itsmeibii/SplitFlap-Control-Board/housing/enclosure/preview.png

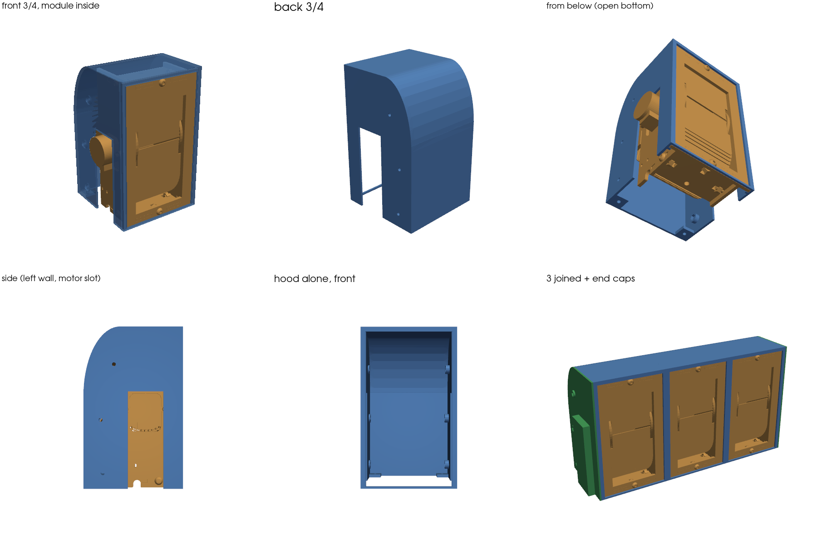
housing/enclosure/preview.png
