itsmeibii/SplitFlap-Control-Board/control board/ControlBoard/fab/DigiKey_BOM.csv

Qty per board | References | Value | Footprint | DigiKey Part # | Who solders
2 | C1 C2 | 10u | C_1206_3216Metric | 4713-GMC31X7R106K50NTCT-ND | You
3 | C3 C6 C11 | 0.1u | C_0805_2012Metric | 1276-1003-1-ND | You
1 | C4 | 47n | C_0805_2012Metric | 399-C0805C473K5RACTUCT-ND | You
1 | C5 | 150p | C_0805_2012Metric | 399-C0805C151J5GACTUCT-ND | You
2 | C7 C8 | 22u | C_1210_3225Metric | 490-3889-1-ND | You
2 | C9 C12 | 2.2n | C_0805_2012Metric | 1276-2993-1-ND | You
2 | C10 C14 | 1u | C_0805_2012Metric | 399-C0805C105K3RACTUCT-ND | You
1 | C13 | 47u | C_1210_3225Metric | 587-5479-1-ND | You
1 | D1 | SMAJ6.0A | D_SMA | SMAJ6.0ALFCT-ND | You
1 | D2 | SMAJ22A | D_SMA | SMAJ22ABCT-ND | You
1 | D3 | LTST-C170KRKT | LED_0805_2012Metric_Pad1.15x1.40mm_HandSolder | 160-1415-1-ND | You
1 | D4 | LTST-C170KGKT | LED_0805_2012Metric_Pad1.15x1.40mm_HandSolder | 160-1414-1-ND | You
1 | D5 | LTST-C170TBKT | LED_0805_2012Metric_Pad1.15x1.40mm_HandSolder | 160-1579-1-ND | You
1 | F1 | 3A | Fuseholder_Blade_Mini_Keystone_3568 | 36-3568-ND | You
1 | F2 | 7.5A | Fuseholder_Blade_Mini_Keystone_3568 | 36-3568-ND | You
1 | J1 | Conn_02x04_Odd_Even | IDC-Header_2x04_P2.54mm_Vertical | 732-5395-ND | You
1 | J2 | Conn_02x08_Odd_Even | IDC-Header_2x08_P2.54mm_Vertical | 732-2095-ND | You
1 | J4 | Conn_01x02_Pin | TerminalBlock_CUI_TB007-508-02_1x02_P5.08mm_Horizontal | 102-6203-ND | You
1 | J5 | Conn_01x03_Pin | TerminalBlock_CUI_TB007-508-03_1x03_P5.08mm_Horizontal | 102-6204-ND | You
1 | J6 | Raspberry_Pi_4 | PinSocket_2x20_P2.54mm_Vertical | 2223-SSK04-FPH-254-B20-ND | You
1 | L1 | 3.3u | L_Wuerth_HCI-1050 | 732-1169-1-ND | You
2 | R1 R11 | 220 | R_0805_2012Metric | 311-220CRCT-ND | You
1 | R2 | 169k | R_0805_2012Metric | RMCF0805FT169KCT-ND | You
1 | R3 | 36.5k | R_0805_2012Metric | 311-36.5KCRCT-ND | You
1 | R4 | 52.3k | R_0805_2012Metric | 311-52.3KCRCT-ND | You
2 | R5 R14 | 10k | R_0805_2012Metric | 311-10.0KCRCT-ND | You
1 | R7 | 73.2k | R_0805_2012Metric | 311-73.2KCRCT-ND | You
1 | R8 | 49.9 | R_0805_2012Metric | 311-49.9CRCT-ND | You
1 | R10 | 49.9k | R_0805_2012Metric | 311-49.9KCRCT-ND | You
1 | R12 | 35.7k | R_0805_2012Metric | 311-35.7KCRCT-ND | You
1 | R13 | 2.87k | R_0805_2012Metric | 311-2.87KCRCT-ND | You
1 | R15 | 953 | R_0805_2012Metric | 311-953CRCT-ND | You
2 | R16 R17 | 47k | R_0805_2012Metric | 311-47.0KCRCT-ND | You
1 | R18 | 16.5k | R_0805_2012Metric | 311-16.5KCRCT-ND | You
1 | R19 | 1k | R_0805_2012Metric | 311-1.00KCRCT-ND | You
2 | SW1 SW2 | SW_Push | SW_PUSH_6mm | SW400-ND | You
1 | U1 | Adafruit_HUSB238_Breakout | Adafruit_HUSB238_Breakout | 1528-5807-ND | You
1 | U2 | TPS56A37RPA | Texas_RPA0010A_VQFN-HR-10_3x3mm_P0.5mm | 296-TPS56A37RPARCT-ND | JLC (Global Sourcing - do not order)
1 | U3 | TPS259474ARPW | Texas_RPW0010A_VQFN-HR-10_2x2mm_P0.475mm | 296-TPS259474ARPWRCT-ND | JLC (Global Sourcing - do not order)
6 | TP1,TP2,TP3,TP4,TP5,TP6 | TestPoint | TestPoint_Pad_D1.0mm | (none - bare copper pad) | Nothing to buy or solder
