itsmeibii/SplitFlap-Control-Board/control board/ControlBoard/fab/jlc_assembly/ControlBoard_BOM_JLC.csv

Comment | Designator | Footprint | LCSC Part # | Manufacturer | Manufacturer Part Number
TPS56A37RPAR | U2 | Texas_RPA0010A_VQFN-HR-10_3x3mm_P0.5mm |  | Texas Instruments | TPS56A37RPAR
TPS259474ARPWR | U3 | Texas_RPW0010A_VQFN-HR-10_2x2mm_P0.475mm |  | Texas Instruments | TPS259474ARPWR
