itsmeibii/SplitFlap-Control-Board/housing/enclosure/row_assembly.step

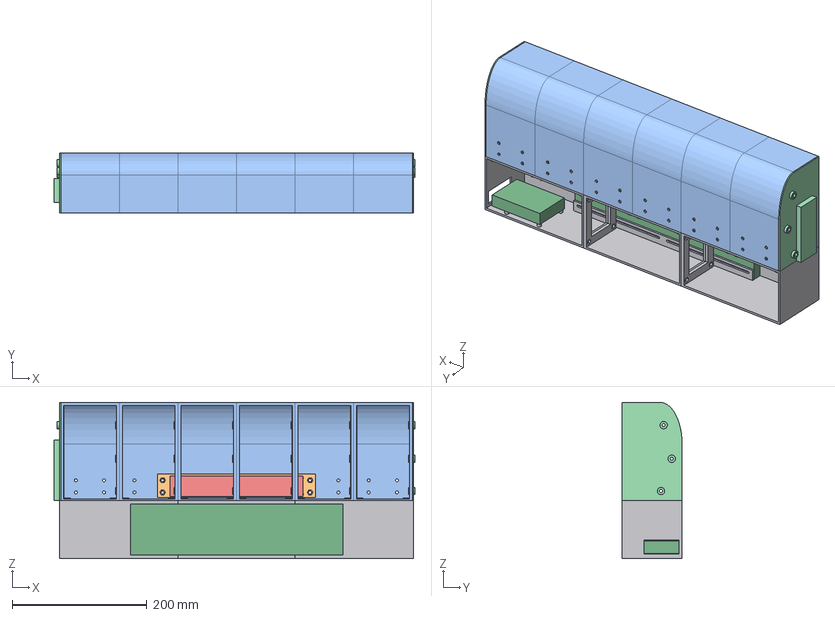
[picture p9: CAD file, 2026-10-20]
housing/enclosure/row_assembly.step
536.8 x 89.6 x 232.5 mm
hood_1
hood_2
hood_3
hood_4
hood_5
hood_6
endcap_left
endcap_right
base_seg_A
base_seg_B
base_seg_C
driver_carrier
REF_panels
REF_driver_pcb
REF_driver_parts
REF_pi4
