itsmeibii/SplitFlap-Control-Board/control board/ControlBoard/3dmodels/Littelfuse_01000057Z.step

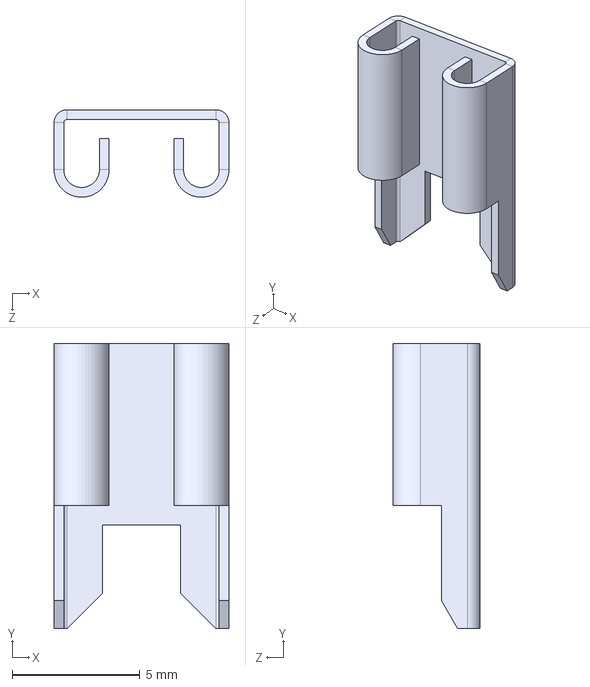
[picture p10: CAD file, 2026-10-20]
control board/ControlBoard/3dmodels/Littelfuse_01000057Z.step
6.86 x 11.2 x 3.43 mm
