itsmeibii/SplitFlap-Control-Board/housing/enclosure/base_seg_C.step

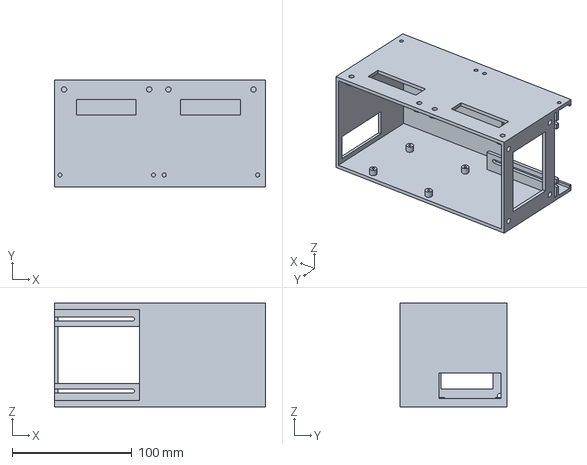
[picture p11: CAD file, 2026-10-20]
housing/enclosure/base_seg_C.step
176.2 x 89.6 x 86.6 mm
