itsmeibii/SplitFlap-Control-Board/housing/splitflap_module_52.stl

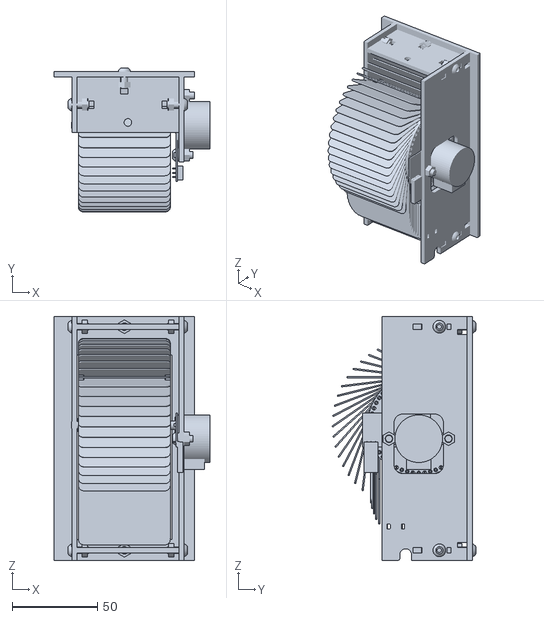
[picture p12: CAD file, 2026-10-20]
housing/splitflap_module_52.stl
91.5 x 84.7 x 143.5
