itsmeibii/SplitFlap-Control-Board/housing/enclosure/endcap_left.step

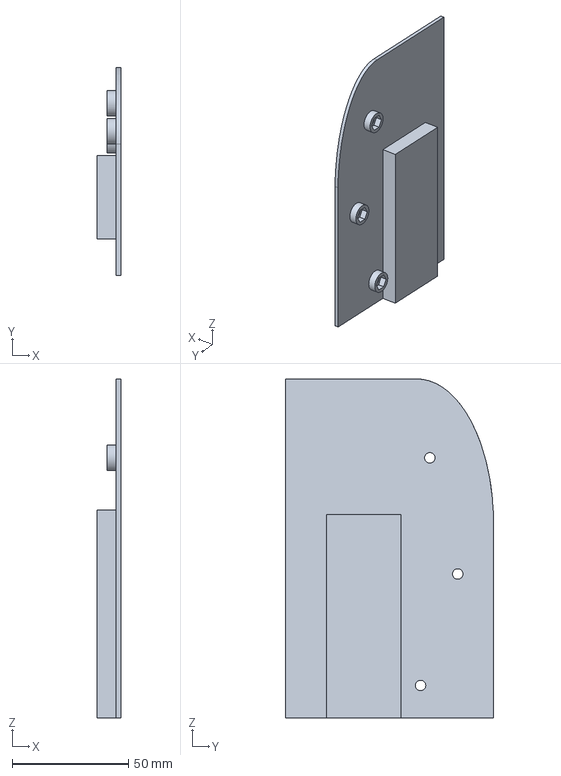
[picture p13: CAD file, 2026-10-20]
housing/enclosure/endcap_left.step
10.2 x 89.6 x 145.9 mm
