itsmeibii/SplitFlap-Control-Board/housing/front_plate_52.stl

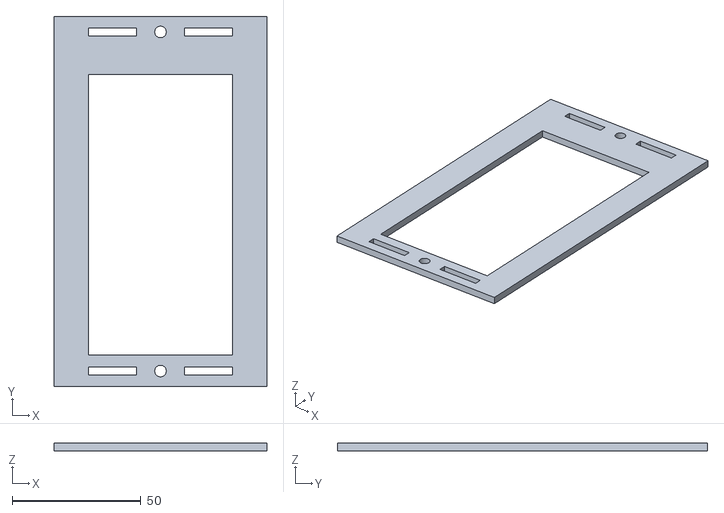
[picture p14: CAD file, 2026-10-20]
housing/front_plate_52.stl
82.6 x 143.5 x 3.00
