itsmeibii/SplitFlap-Control-Board/housing/enclosure/hood.step

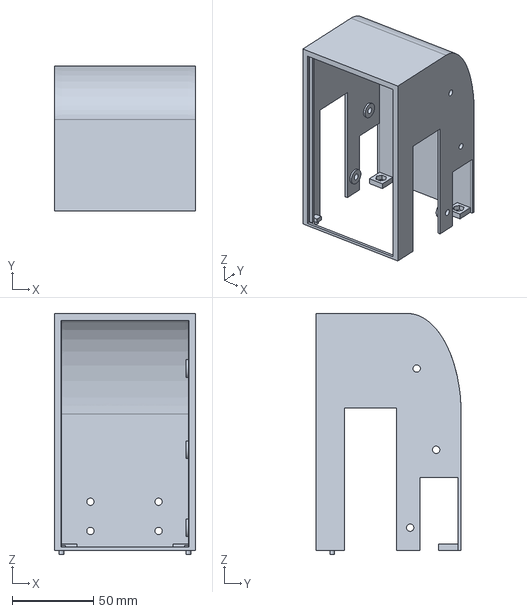
[picture p15: CAD file, 2026-10-20]
housing/enclosure/hood.step
87.1 x 89.6 x 148.4 mm
