itsmeibii/SplitFlap-Control-Board/housing/enclosure/driver_carrier.step

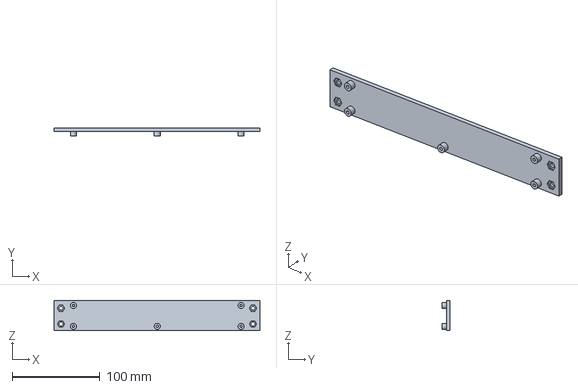
[picture p16: CAD file, 2026-10-20]
housing/enclosure/driver_carrier.step
235.3 x 9.00 x 34.5 mm
