itsmeibii/SplitFlap-Control-Board/housing/enclosure/base_seg_B.step

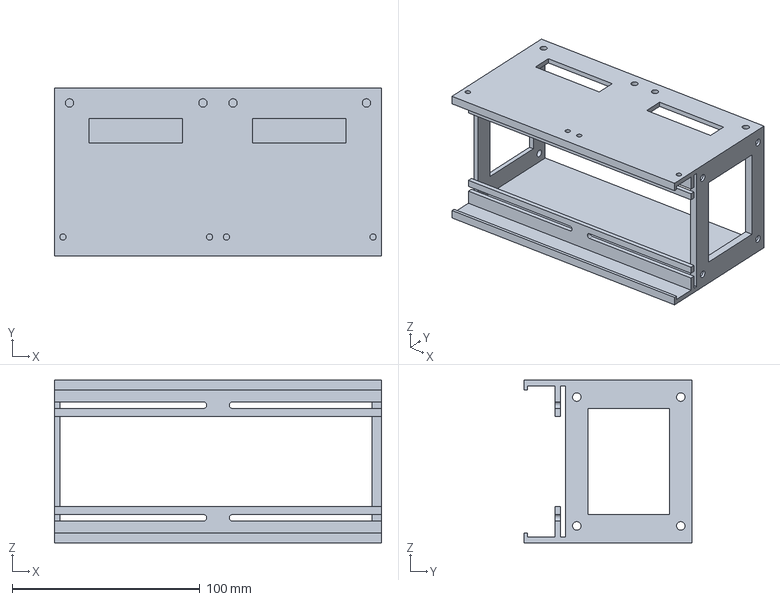
[picture p17: CAD file, 2026-10-20]
housing/enclosure/base_seg_B.step
174.2 x 89.6 x 86.6 mm
