itsmeibii/SplitFlap-Control-Board/housing/enclosure/endcap_right.step

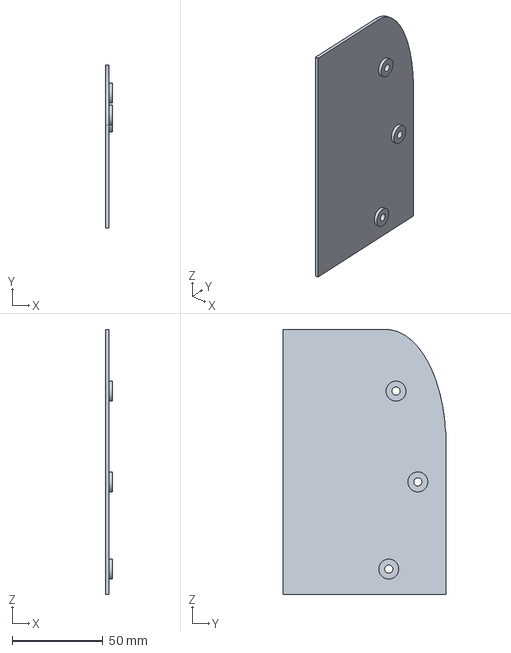
[picture p18: CAD file, 2026-10-20]
housing/enclosure/endcap_right.step
4.00 x 89.6 x 145.9 mm
