itsmeibii/SplitFlap-Control-Board/(list of files, cad)

Other CAD files:
housing/enclosure/base_seg_A.step
housing/enclosure/base_seg_A.stl
housing/enclosure/base_seg_B.stl
housing/enclosure/base_seg_C.stl
housing/enclosure/driver_carrier.stl
housing/enclosure/endcap_left.stl
housing/enclosure/endcap_right.stl
housing/enclosure/hood.stl
housing/front_plate_52.dxf
