itsmeibii/SplitFlap-Control-Board/docs/SplitFlap-schematic.pdf

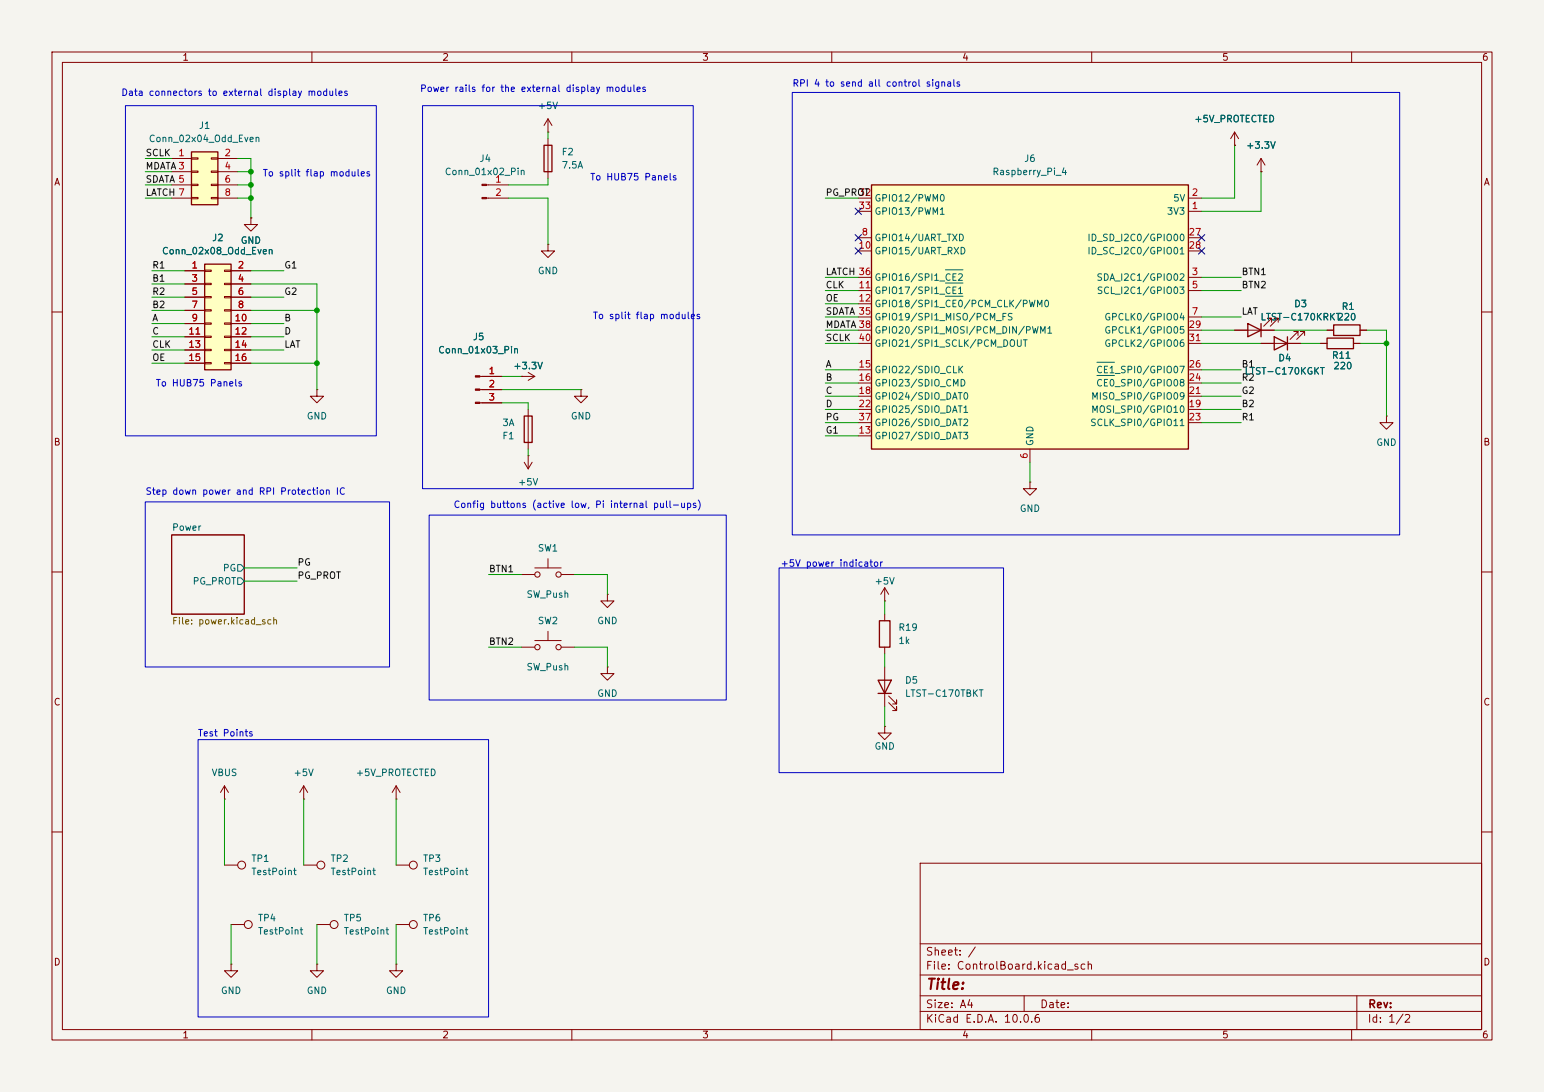
[picture p19: page 1]

RPI 4 to send all control signals Data connectors to external display modules

To split flap modules

Size: A4 | Rev:
KiCad E.D.A. 10.0.6 | Id: 1/2

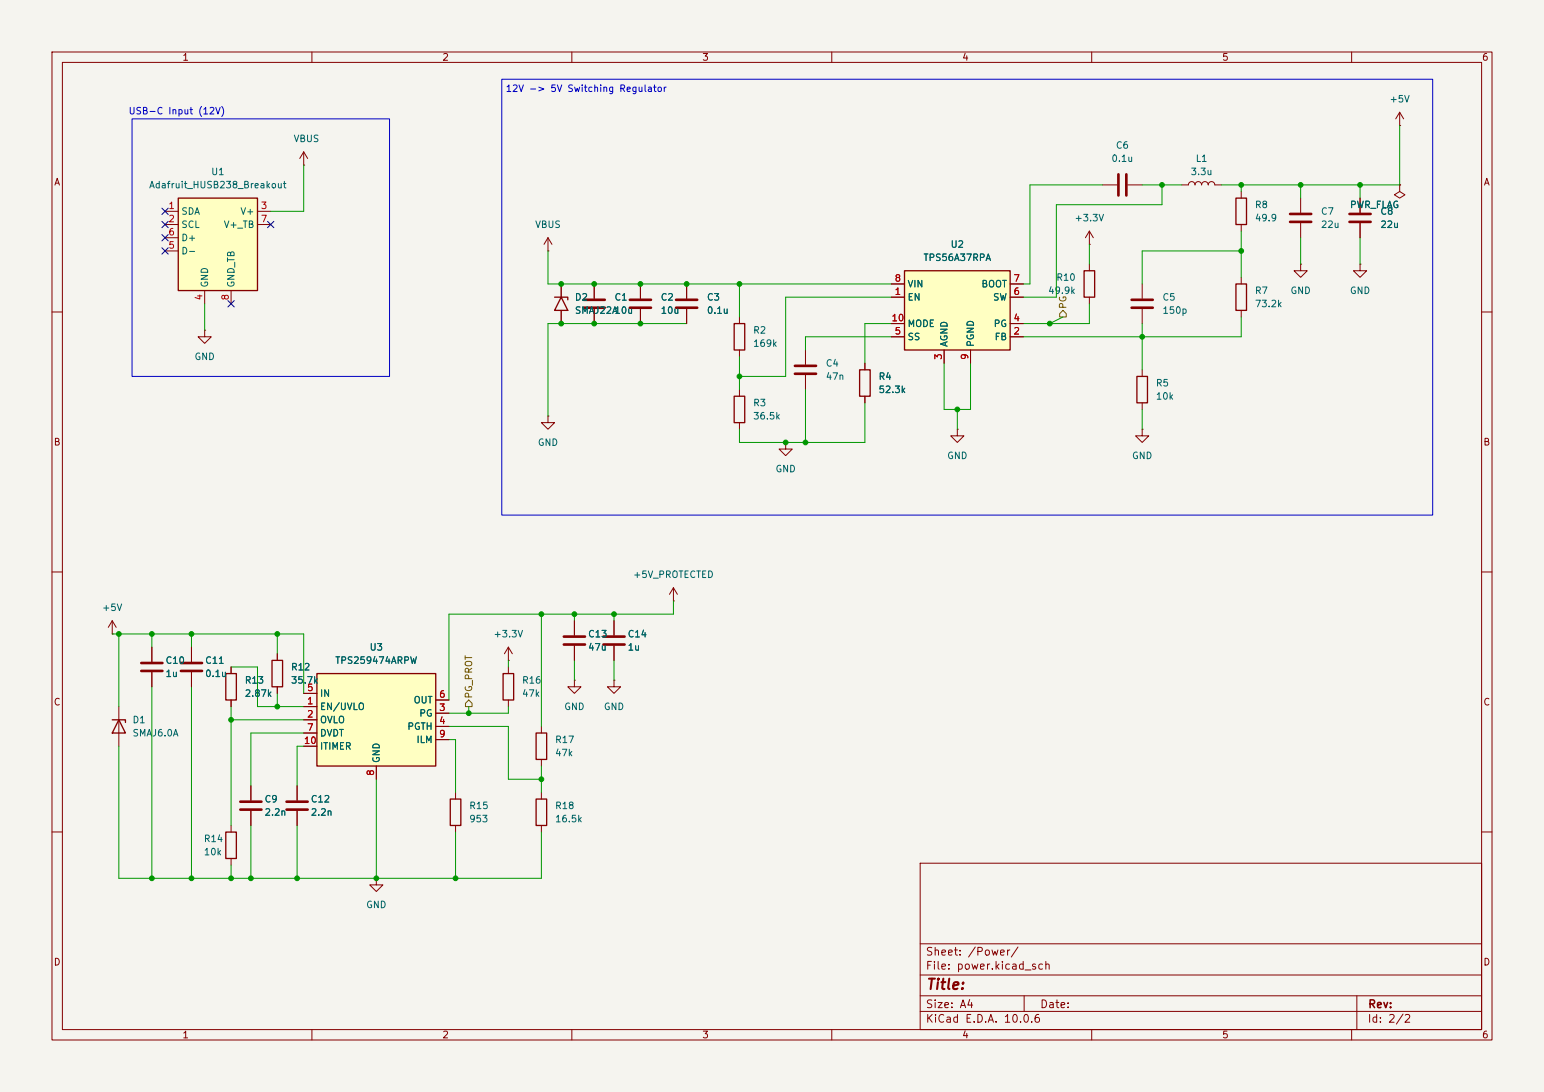
[picture p20: page 2]

Size: A4 | Rev:
KiCad E.D.A. 10.0.6 | Id: 2/2
