itsmeibii/SplitFlap-Control-Board/control board/ControlBoard/ControlBoard.kicad_pcb

## KiCad design control board/ControlBoard/ControlBoard.kicad_pcb (2026-10-20)

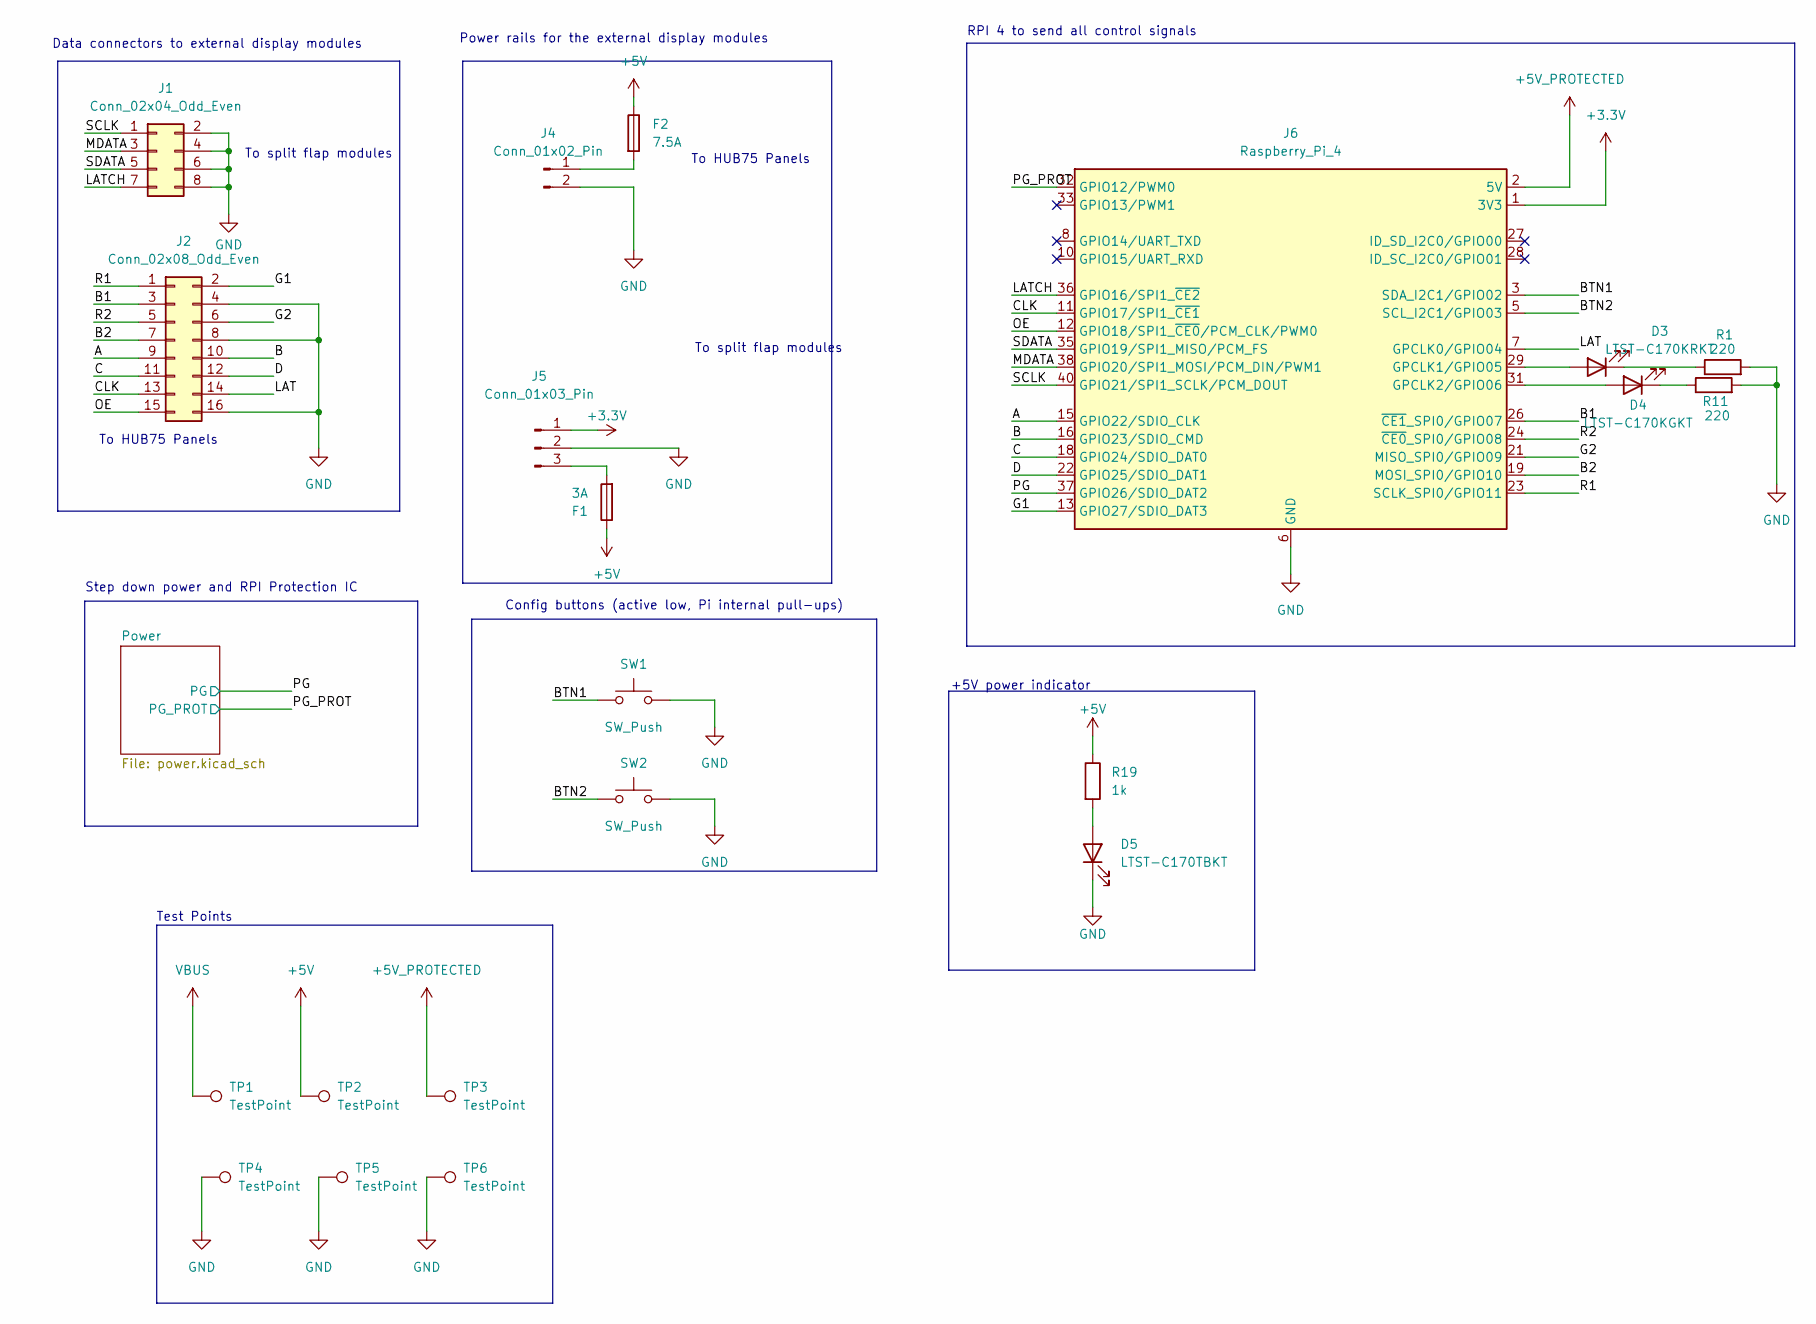
[picture p21: schematic ControlBoard.kicad_sch]

Parts:
D3: LTST-C170KRKT; LED_0805_2012Metric_Pad1.15x1.40mm_HandSolder; DigiKey Part # 160-1415-1-ND
D4: LTST-C170KGKT; LED_0805_2012Metric_Pad1.15x1.40mm_HandSolder; DigiKey Part # 160-1414-1-ND
D5: LTST-C170TBKT; LED_0805_2012Metric_Pad1.15x1.40mm_HandSolder; DigiKey Part # 160-1579-1-ND
F1: 3A; Fuseholder_Blade_Mini_Keystone_3568; MPN 3568; DigiKey Part # 36-3568-ND
F2: 7.5A; Fuseholder_Blade_Mini_Keystone_3568; MPN 3568; DigiKey Part # 36-3568-ND
J1: Conn_02x04_Odd_Even; IDC-Header_2x04_P2.54mm_Vertical; DigiKey Part # 732-5395-ND
J2: Conn_02x08_Odd_Even; IDC-Header_2x08_P2.54mm_Vertical; DigiKey Part # 732-2095-ND
J4: Conn_01x02_Pin; TerminalBlock_CUI_TB007-508-02_1x02_P5.08mm_Horizontal; DigiKey Part # 102-6191-ND
J5: Conn_01x03_Pin; TerminalBlock_CUI_TB007-508-03_1x03_P5.08mm_Horizontal; DigiKey Part # 102-6204-ND
J6: Raspberry_Pi_4; PinSocket_2x20_P2.54mm_Vertical; DigiKey Part # 2223-SSK04-FPH-254-B20-ND
R1, R11: 220; R_0805_2012Metric; DigiKey Part # 311-220CRCT-ND
R19: 1k; R_0805_2012Metric; DigiKey Part # 311-1.00KCRCT-ND
SW1, SW2: SW_Push; SW_PUSH_6mm; DigiKey Part # SW400-ND
TP1, TP2, TP3, TP4, TP5, TP6: TestPoint; TestPoint_Pad_D1.0mm

Connections:
+3.3V: J5.1, J6.1 (3V3), J6.17 (3V3); also elsewhere on the board
+5V: F1.1, F2.1, R19.1, TP2.1 (1_1); also elsewhere on the board
+5V_PROTECTED: J6.2 (5V), J6.4 (5V), TP3.1 (1_1); also elsewhere on the board
/A: J2.9, J6.15 (GPIO22/SDIO_CLK)
/B: J2.10, J6.16 (GPIO23/SDIO_CMD)
/B1: J2.3, J6.26 (~CE1_SPI0/GPIO07)
/B2: J2.7, J6.19 (MOSI_SPI0/GPIO10)
/BTN1: J6.3 (SDA_I2C1/GPIO02), SW1.1
/BTN2: J6.5 (SCL_I2C1/GPIO03), SW2.1
/C: J2.11, J6.18 (GPIO24/SDIO_DAT0)
/CLK: J2.13, J6.11 (GPIO17/SPI1_~CE1)
/D: J2.12, J6.22 (GPIO25/SDIO_DAT1)
/G1: J2.2, J6.13 (GPIO27/SDIO_DAT3)
/G2: J2.6, J6.21 (MISO_SPI0/GPIO09)
/LAT: J2.14, J6.7 (GPCLK0/GPIO04)
/LATCH: J1.7, J6.36 (GPIO16/SPI1_~CE2)
/MDATA: J1.3, J6.38 (GPIO20/SPI1_MOSI/PCM_DIN/PWM1)
/OE: J2.15, J6.12 (GPIO18/SPI1_~CE0/PCM_CLK/PWM0)
/PG: J6.37 (GPIO26/SDIO_DAT2); also elsewhere on the board
/PG_PROT: J6.32 (GPIO12/PWM0); also elsewhere on the board
/R1: J2.1, J6.23 (SCLK_SPI0/GPIO11)
/R2: J2.5, J6.24 (~CE0_SPI0/GPIO08)
/SCLK: J1.1, J6.40 (GPIO21/SPI1_SCLK/PCM_DOUT)
/SDATA: J1.5, J6.35 (GPIO19/SPI1_MISO/PCM_FS)
GND: D5.1 (K), J1.2, J1.4, J1.6, J1.8, J2.4, J2.8, J2.16, J4.2, J5.2, J6.6 (GND), J6.9 (GND), J6.14 (GND), J6.20 (GND), J6.25 (GND), J6.30 (GND), J6.34 (GND), J6.39 (GND), R1.2, R11.2, SW1.2, SW2.2, TP4.1 (1_1), TP5.1 (1_1), TP6.1 (1_1); also elsewhere on the board
unnamed: D3.2 (A), J6.29 (GPCLK1/GPIO05)
unnamed: D3.1 (K), R1.1
unnamed: D4.2 (A), J6.31 (GPCLK2/GPIO06)
unnamed: D4.1 (K), R11.1
unnamed: D5.2 (A), R19.2
unnamed: F2.2, J4.1
unnamed: F1.2, J5.3
VBUS: TP1.1 (1_1); also elsewhere on the board

Notes on the sheet:
+5V power indicator
RPI 4 to send all control signals
To split flap modules
Power rails for the external display modules
Step down power and RPI Protection IC
Config buttons (active low, Pi internal pull-ups)
Data connectors to external display modules
To HUB75 Panels
Test Points

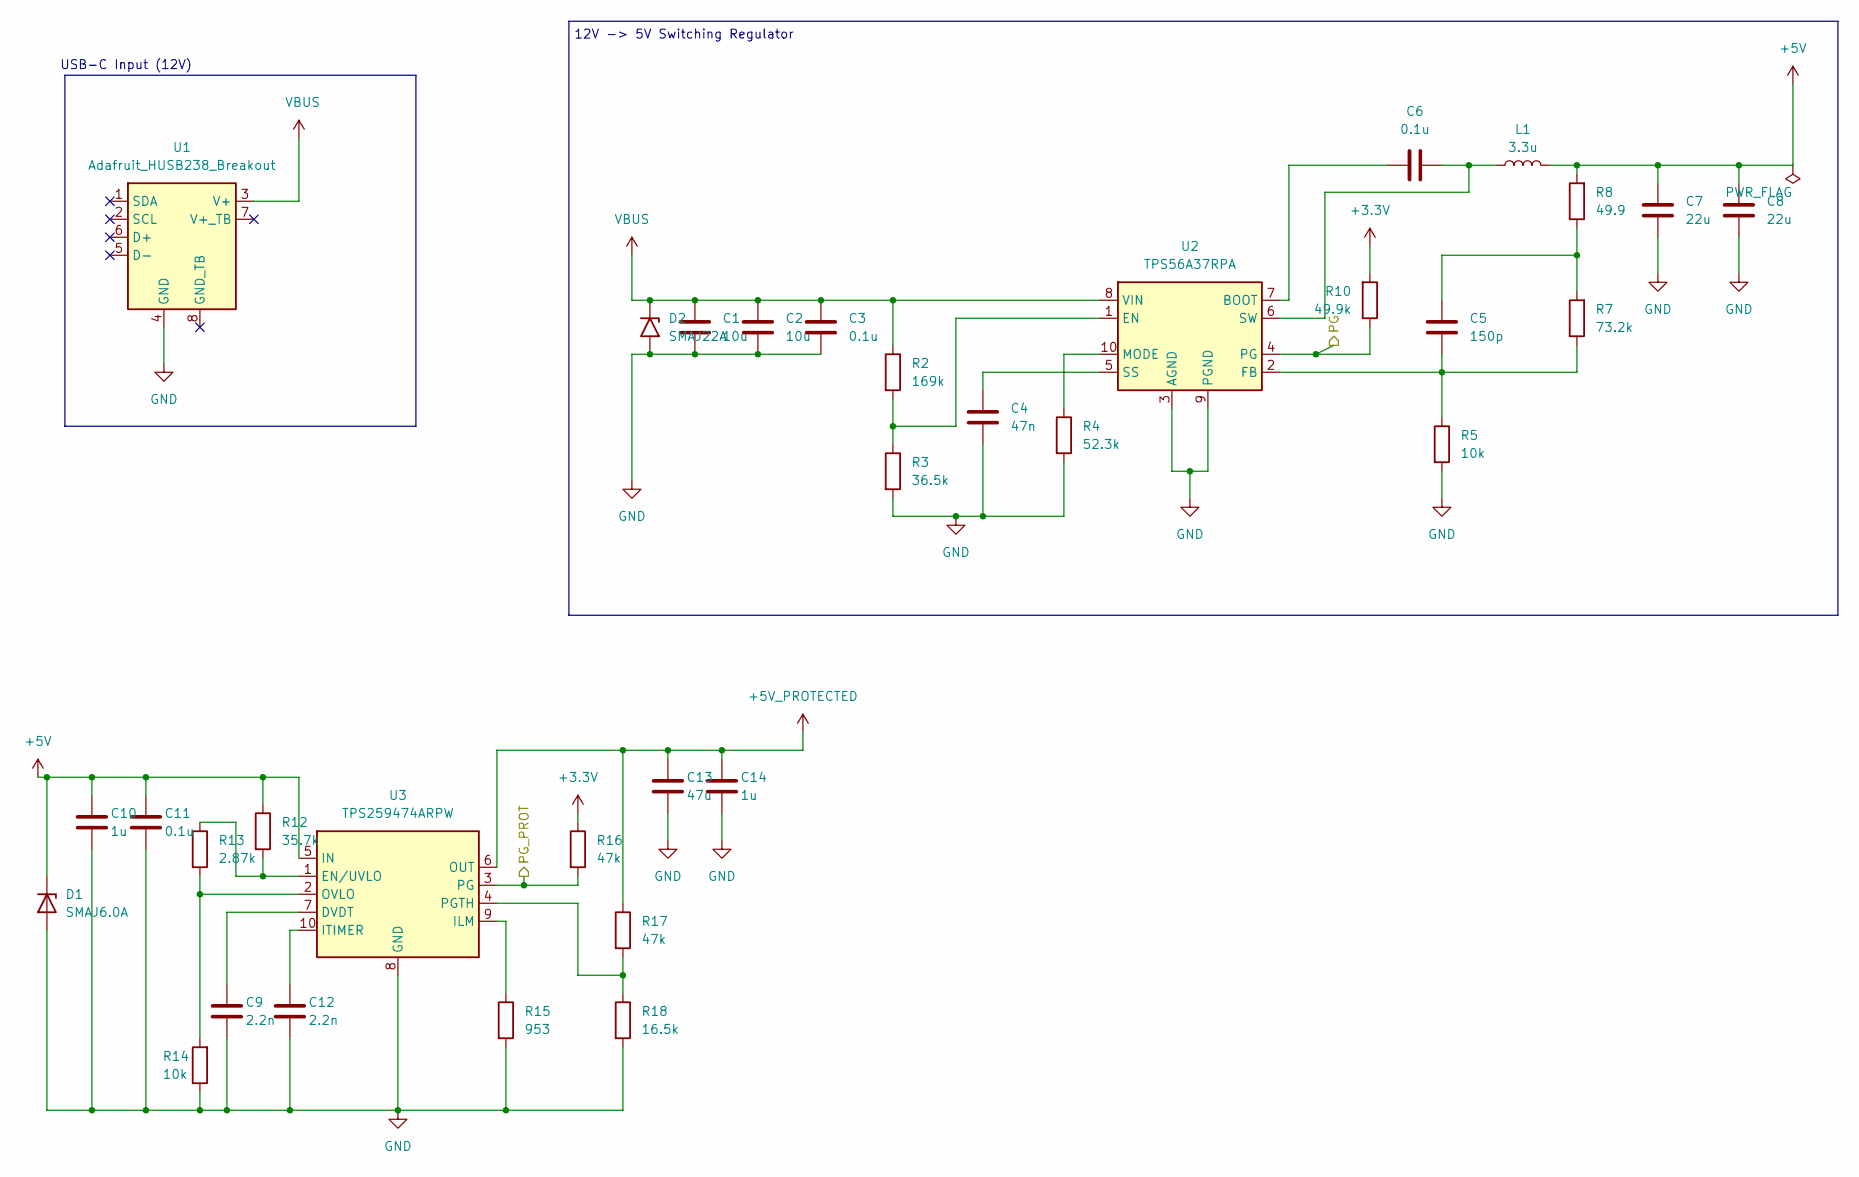
[picture p22: schematic power.kicad_sch]

Parts:
C1, C2: 10u; C_1206_3216Metric; DigiKey Part # 4713-GMC31X7R106K50NTCT-ND
C3, C6, C11: 0.1u; C_0805_2012Metric; DigiKey Part # 1276-1003-1-ND
C4: 47n; C_0805_2012Metric; DigiKey Part # 399-C0805C473K5RACTUCT-ND
C5: 150p; C_0805_2012Metric; DigiKey Part # 399-C0805C151J5GACTUCT-ND
C7, C8: 22u; C_1210_3225Metric; DigiKey Part # 490-3889-1-ND
C9, C12: 2.2n; C_0805_2012Metric; DigiKey Part # 1276-2993-1-ND
C10, C14: 1u; C_0805_2012Metric; DigiKey Part # 399-C0805C105K3RACTUCT-ND
C13: 47u; C_1210_3225Metric; DigiKey Part # 587-5479-1-ND
D1: SMAJ6.0A; D_SMA; DigiKey Part # SMAJ6.0ALFCT-ND
D2: SMAJ22A; D_SMA; DigiKey Part # SMAJ22ABCT-ND
L1: 3.3u; L_Wuerth_HCI-1050; DigiKey Part # 732-1169-1-ND
R2: 169k; R_0805_2012Metric; DigiKey Part # RMCF0805FT169KCT-ND
R3: 36.5k; R_0805_2012Metric; DigiKey Part # 311-36.5KCRCT-ND
R4: 52.3k; R_0805_2012Metric; DigiKey Part # 311-52.3KCRCT-ND
R5, R14: 10k; R_0805_2012Metric; DigiKey Part # 311-10.0KCRCT-ND
R7: 73.2k; R_0805_2012Metric; DigiKey Part # 311-73.2KCRCT-ND
R8: 49.9; R_0805_2012Metric; DigiKey Part # 311-49.9CRCT-ND
R10: 49.9k; R_0805_2012Metric; DigiKey Part # 311-49.9KCRCT-ND
R12: 35.7k; R_0805_2012Metric; DigiKey Part # 311-35.7KCRCT-ND
R13: 2.87k; R_0805_2012Metric; DigiKey Part # 311-2.87KCRCT-ND
R15: 953; R_0805_2012Metric; DigiKey Part # 311-953CRCT-ND
R16, R17: 47k; R_0805_2012Metric; DigiKey Part # 311-47.0KCRCT-ND
R18: 16.5k; R_0805_2012Metric; DigiKey Part # 311-16.5KCRCT-ND
U1: Adafruit_HUSB238_Breakout; DigiKey 1528-5807-ND
U2: TPS56A37RPA; Texas_RPA0010A_VQFN-HR-10_3x3mm_P0.5mm; DigiKey Part # 296-TPS56A37RPARCT-ND
U3: TPS259474ARPW; Texas_RPW0010A_VQFN-HR-10_2x2mm_P0.475mm; DigiKey Part # 296-TPS259474ARPWRCT-ND

Connections:
+3.3V: R10.2, R16.1; also elsewhere on the board
+5V: C7.2, C8.2, C10.1, C11.1, D1.1 (K), L1.2, R8.2, R12.1, U3.5 (IN); also elsewhere on the board
+5V_PROTECTED: C13.1, C14.1, R17.1, U3.6 (OUT); also elsewhere on the board
/PG: R10.1, U2.4 (PG); also elsewhere on the board
/PG_PROT: R16.2, U3.3 (PG); also elsewhere on the board
GND: C1.2, C2.2, C3.2, C4.2, C7.1, C8.1, C9.2, C10.2, C11.2, C12.2, C13.2, C14.2, D1.2 (A), D2.2 (A2), R3.2, R4.2, R5.2, R14.1, R15.2, R18.2, U1.4 (GND), U2.3 (AGND), U2.9 (PGND), U3.8 (GND); also elsewhere on the board
unnamed: C5.1, R7.2, R8.1
unnamed: C6.1, U2.7 (BOOT)
unnamed: R2.2, R3.1, U2.1 (EN)
unnamed: C5.2, R5.1, R7.1, U2.2 (FB)
unnamed: R4.1, U2.10 (MODE)
unnamed: C4.1, U2.5 (SS)
unnamed: C6.2, L1.1, U2.6 (SW)
unnamed: C9.1, U3.7 (DVDT)
unnamed: R12.2, R13.1, U3.1 (EN/UVLO)
unnamed: R15.1, U3.9 (ILM)
unnamed: C12.1, U3.10 (ITIMER)
unnamed: R13.2, R14.2, U3.2 (OVLO)
unnamed: R17.2, R18.1, U3.4 (PGTH)
VBUS: C1.1, C2.1, C3.1, D2.1 (A1), R2.1, U1.3 (V+), U2.8 (VIN); also elsewhere on the board

Notes on the sheet:
USB-C Input (12V)
12V -> 5V Switching Regulator

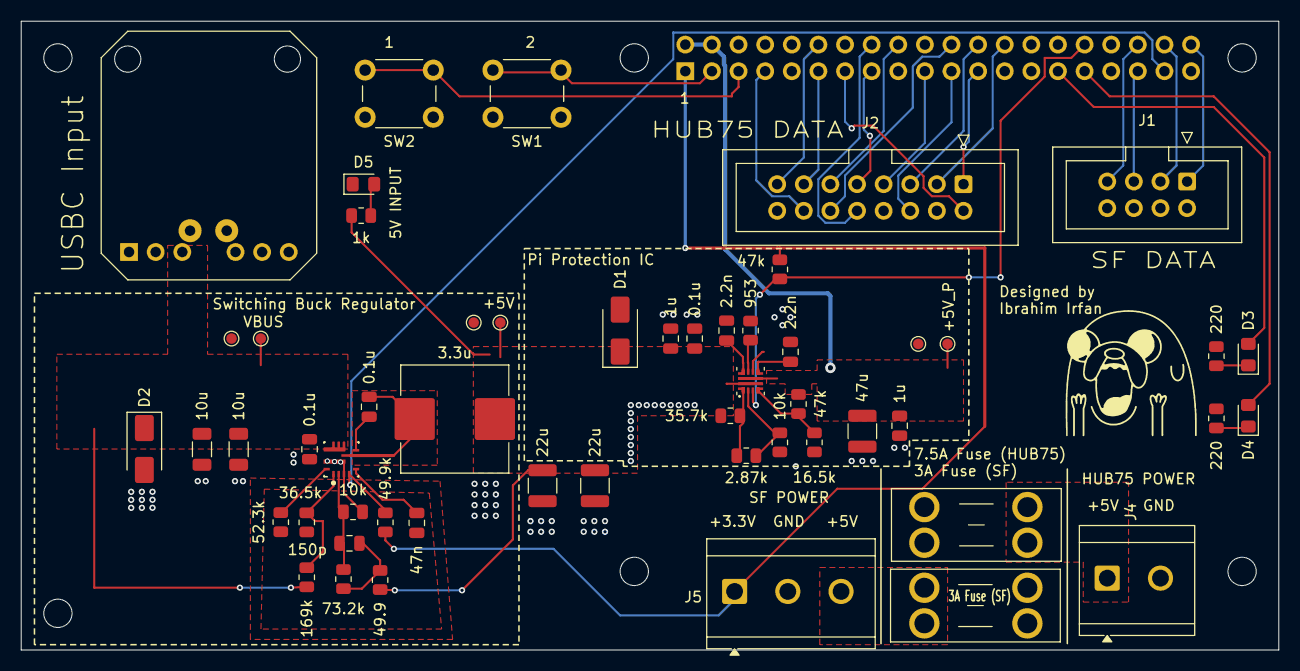
[picture p23: board ControlBoard.kicad_pcb from above]

Board: 2 copper layers, 120.0 x 60.0 mm, 62 parts (1 on the bottom side), 46 nets.

Other parts of the board:
H1, H2, H3, H4, H5, H6: MountingHole_2.7mm_M2.5
LOGO1: Logo_Jake; Logo_Jake_Silkscreen_12mm
