itsmeibii/SplitFlap-Control-Board/(commit log)

2026-10-20 SplitFlap control board: KiCad project, fab files, enclosure, test code
    [ControlBoard-B_Cu.gbl, ControlBoard-B_Mask.gbs, ControlBoard-B_Paste.gbp, ControlBoard-B_Silkscreen.gbo, ControlBoard-Edge_Cuts.gm1, ControlBoard-F_Cu.gtl, ControlBoard-F_Mask.gts, ControlBoard-F_Paste.gtp]
2026-10-20 Add enclosure 3D render to README
